MahdiAllaw1/Drone-Stabilizer-PID/Project_photo.jpg

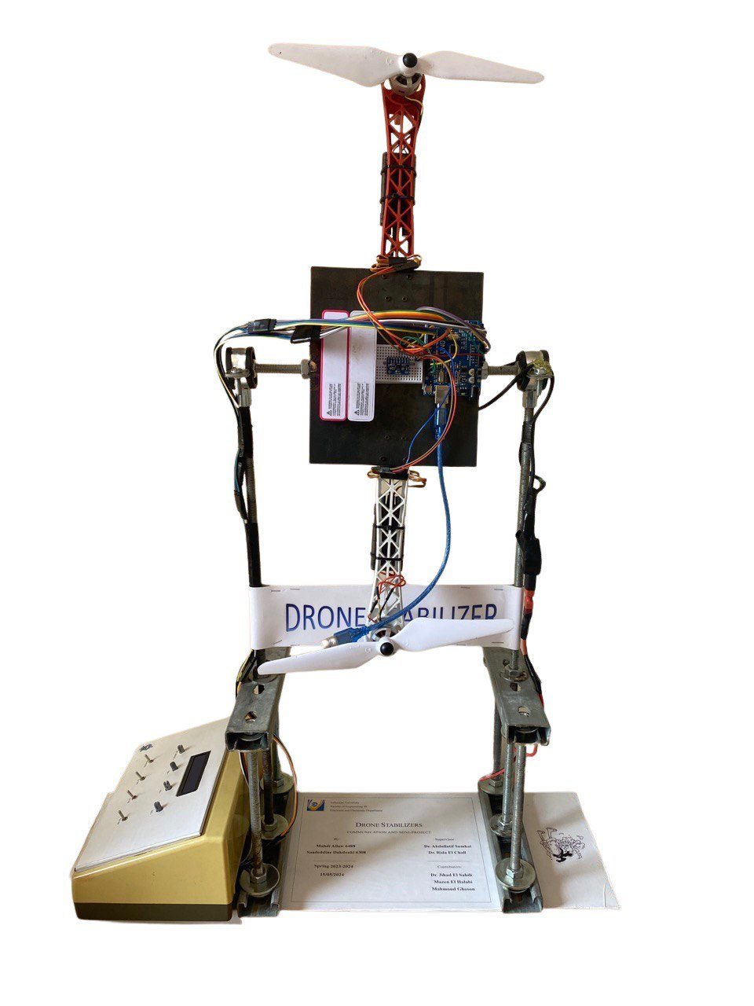
Project_photo.jpg
